glenracing/bmw-e36-abs-adapter/Readme.md

# bmw-e36-abs-adapter

BMW E36 ABS pedal travel sensor adapter and CANbus module.
