glenracing/bmw-e36-abs-adapter/stm32_pinout.png

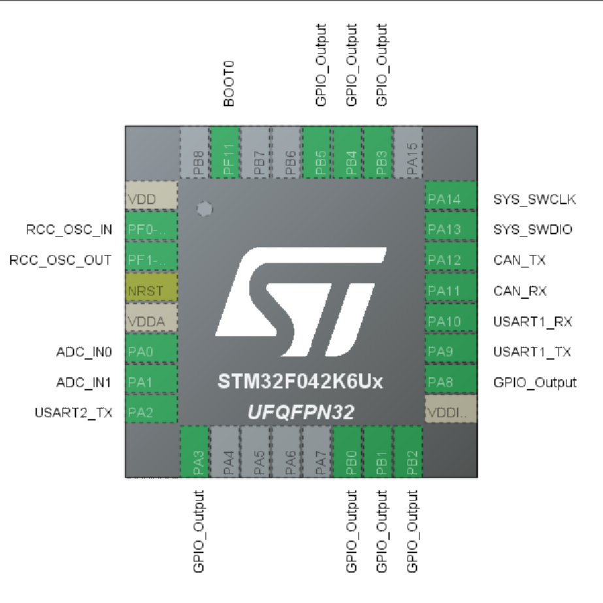
stm32_pinout.png
