glenracing/bmw-e36-abs-adapter/kicad/3d-models/SOP-4_4.4x4.6mm_P2.54mm.step

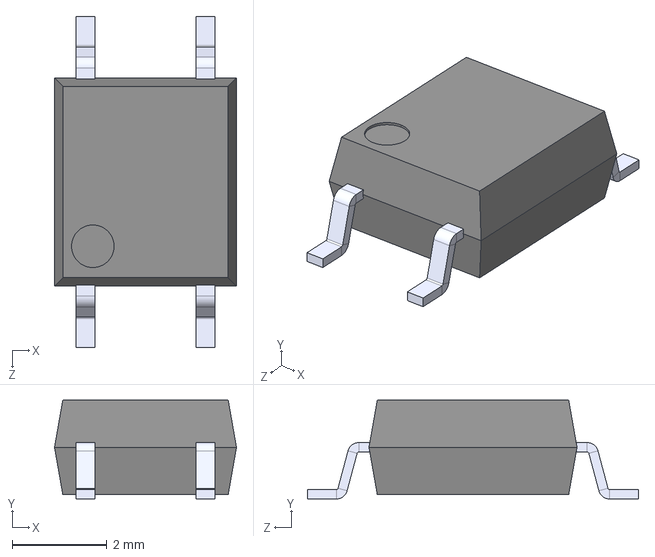
[picture p2: CAD file, 2026-04-06]
kicad/3d-models/SOP-4_4.4x4.6mm_P2.54mm.step
3.85 x 2.09 x 7.00 mm
