glenracing/bmw-e36-abs-adapter/kicad/3d-models/Texas_RDN0011B_QFN-FCMOD-11-3.5x4.5mm-P0.5mm_2EP.step

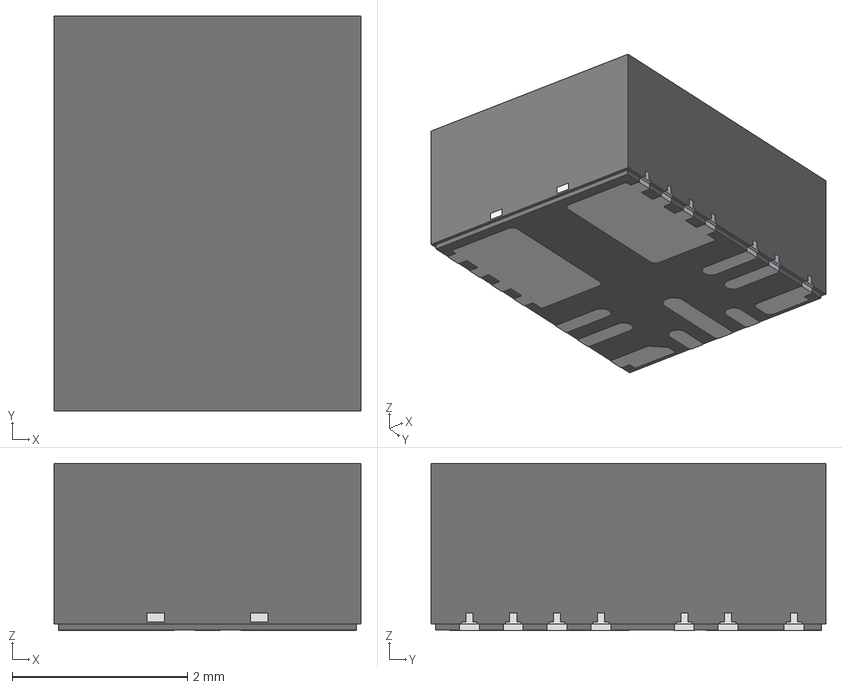
[picture p3: CAD file, 2026-04-06]
kicad/3d-models/Texas_RDN0011B_QFN-FCMOD-11-3.5x4.5mm-P0.5mm_2EP.step
3.50 x 4.50 x 1.91 mm
MOLD_CPOMPOUND_AF0
SOLID1-489_AF0
SOLID1-490_AF0
SOLID1-491_AF0
SOLID1-492_AF0
SOLID1-493_AF0
SOLID1-494_AF0
SOLID1-495_AF0
SOLID1-496_AF0
SOLID1-497_AF0
SOLID1-498_AF0
