glenracing/bmw-e36-abs-adapter/kicad/3d-models/TE_9-6437287-8.step

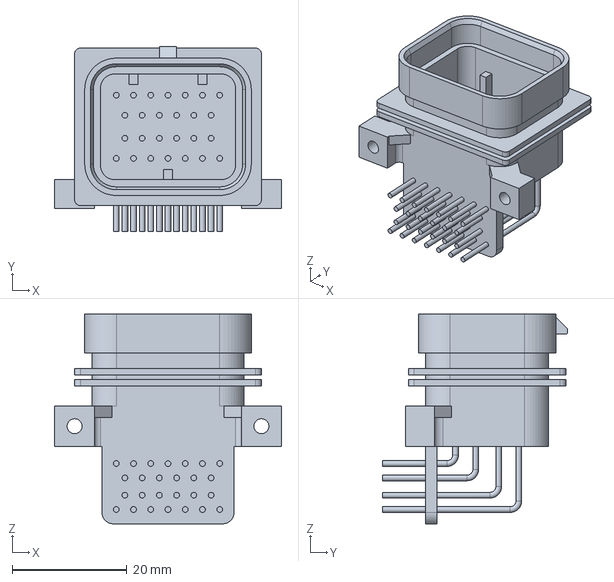
[picture p4: CAD file, 2026-04-06]
kicad/3d-models/TE_9-6437287-8.step
39.5 x 32.1 x 36.5 mm
