glenracing/bmw-e36-abs-adapter/release/Schematic.pdf

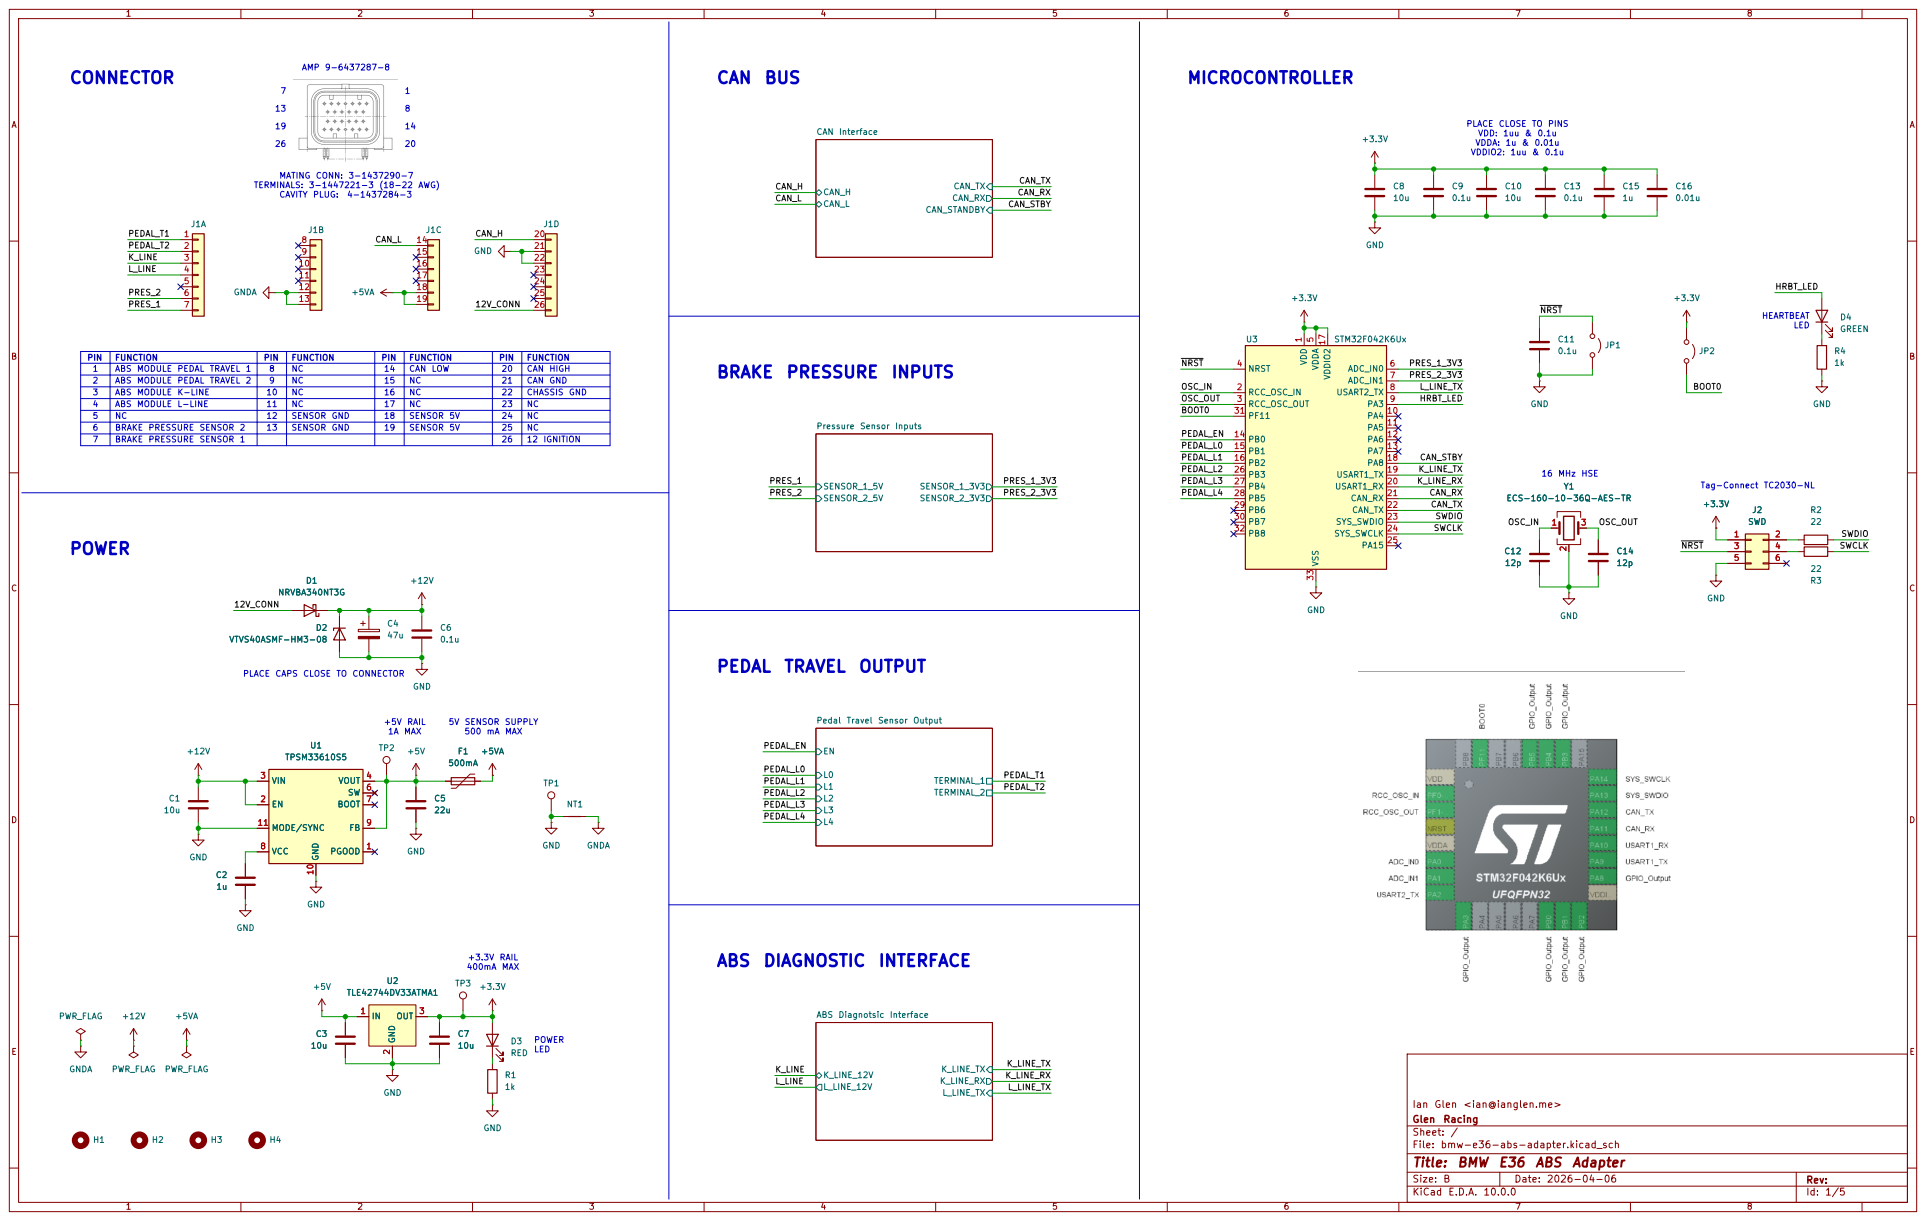
[picture p5: page 1]

CAVITY PLUG: 4-1437284-3 +5V RAIL 1A MAX CONNECTOR

16 MHz HSE CAN BUS

Tag-Connect TC2030-NL MATING CONN: 3-1437290-7

1 | ABS MODULE PEDAL TRAVEL 1 | 8 | NC | 14 | CAN LOW | 20 | CAN HIGH
2 | ABS MODULE PEDAL TRAVEL 2 | 9 | NC | 15 | NC | 21 | CAN GND
3 | ABS MODULE K-LINE | 10 | NC | 16 | NC | 22 | CHASSIS GND
4 | ABS MODULE L-LINE | 11 | NC | 17 | NC | 23 | NC
5 | NC | 12 | SENSOR GND | 18 | SENSOR 5V | 24 | NC
6 | BRAKE PRESSURE SENSOR 2 | 13 | SENSOR GND | 19 | SENSOR 5V | 25 | NC

5V SENSOR SUPPLY 500 mA MAX POWER

PLACE CAPS CLOSE TO CONNECTOR

TERMINAL_2 Pedal Travel Sensor Output GND

Ian Glen <ian@ianglen.me>
Glen Racing
Sheet: /
File: bmw-e36-abs-adapter.kicad_sch
Title: BMW E36 ABS Adapter

Size: B | Rev:

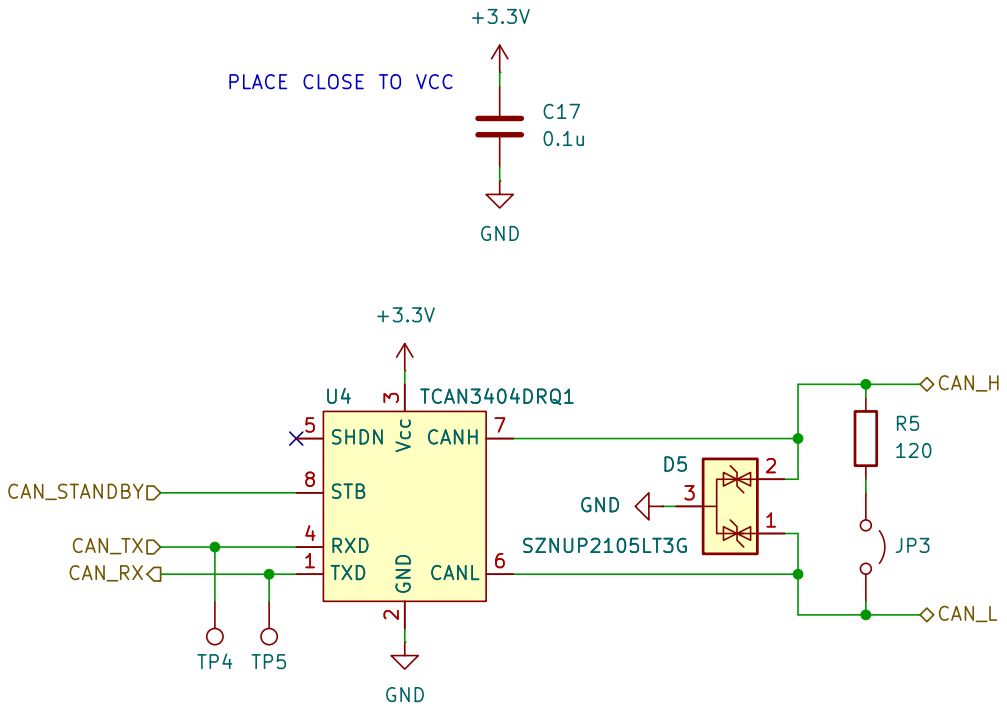
[picture p6: page 2]

2 Vcc 3 RXD 4 CANL 6 CANH 7

Ian Glen <ian@ianglen.me>
Glen Racing
Sheet: /CAN Interface/
File: canbus.kicad_sch
Title: CAN Interface

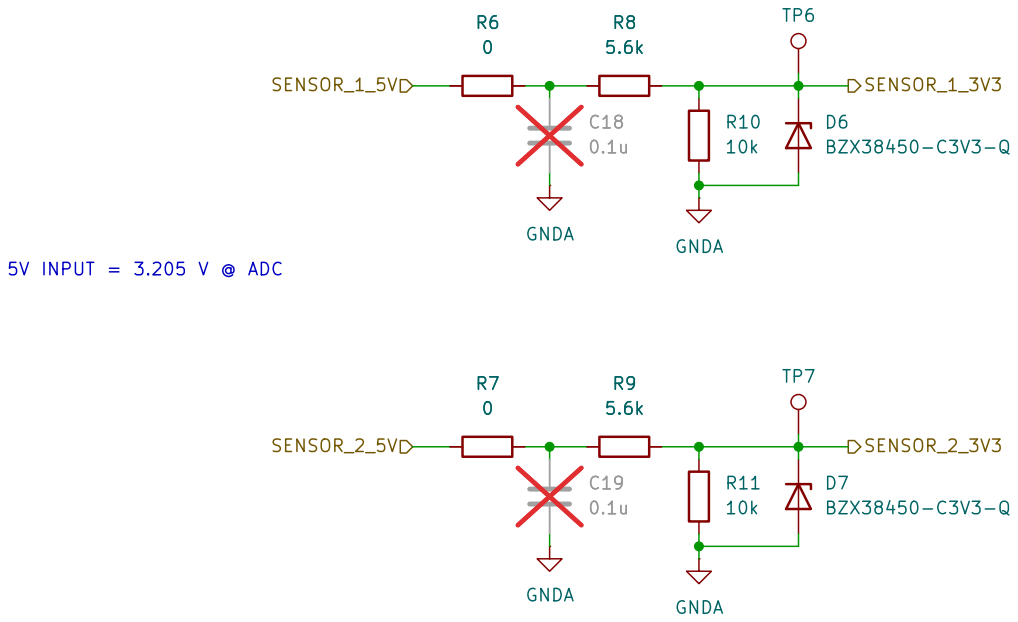
[picture p7: page 3]

Ian Glen <ian@ianglen.me>
Glen Racing
Sheet: /Pressure Sensor Inputs/
File: pressure-sensor-inputs.kicad_sch
Title: Brake Pressure Sensor Inputs

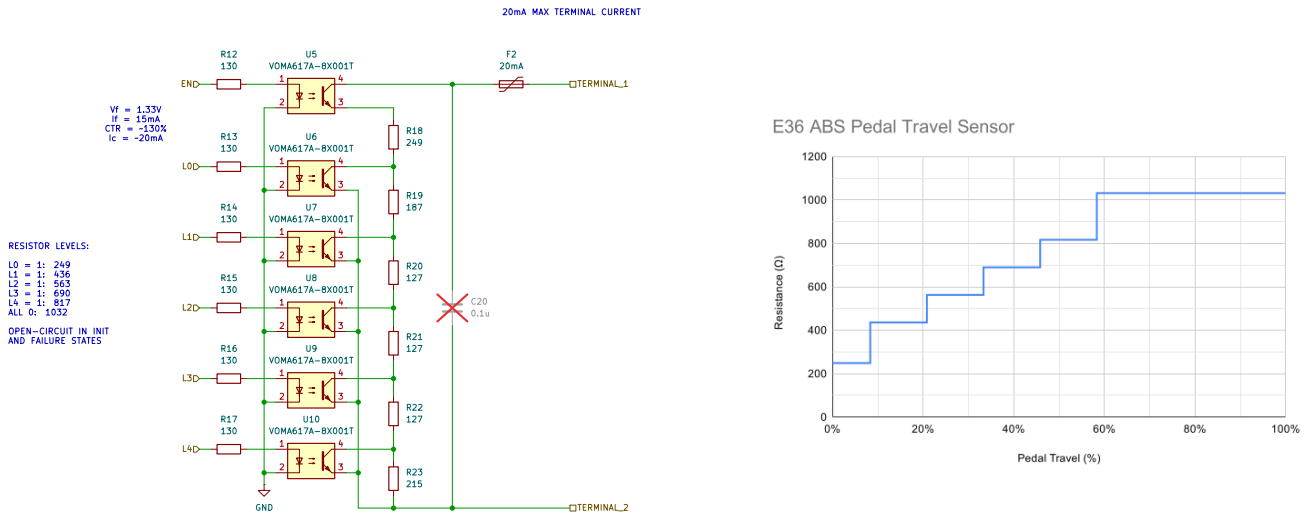
[picture p8: page 4]

Ian Glen <ian@ianglen.me>
Glen Racing
Sheet: /Pedal Travel Sensor Output/
File: pedal-travel-sensor-output.kicad_sch
Title: Pedal Travel Sensor Output

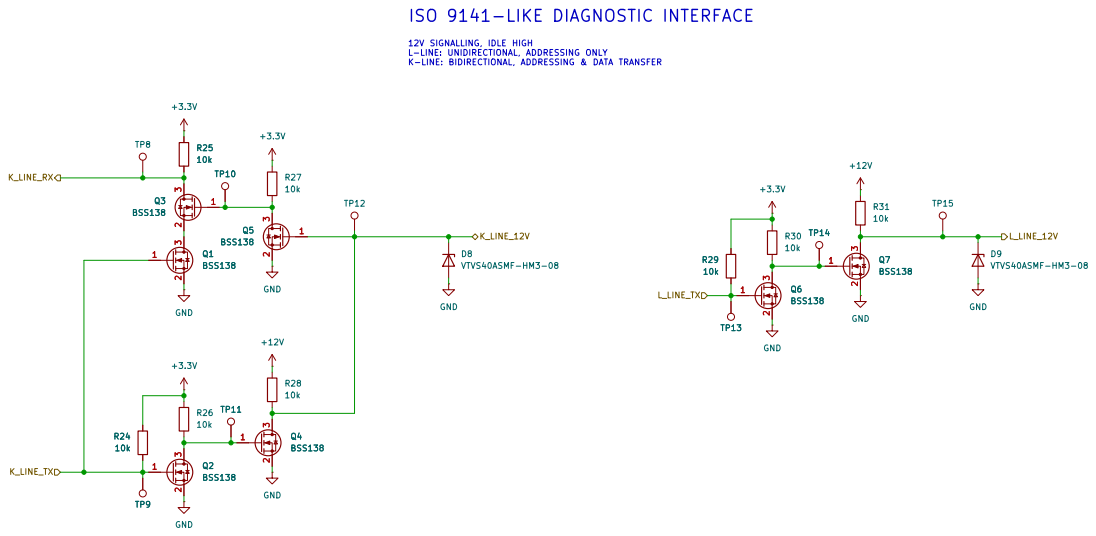
[picture p9: page 5]

ISO 9141-LIKE DIAGNOSTIC INTERFACE

L-LINE: UNIDIRECTIONAL, ADDRESSING ONLY K-LINE: BIDIRECTIONAL, ADDRESSING & DATA TRANSFER Q3 BSS138

Ian Glen <ian@ianglen.me>
Glen Racing
Sheet: /ABS Diagnotsic Interface/
File: abs-interface.kicad_sch
Title: ABS Diagnostic Interface
