glenracing/bmw-e36-abs-adapter/release/BOM.pdf

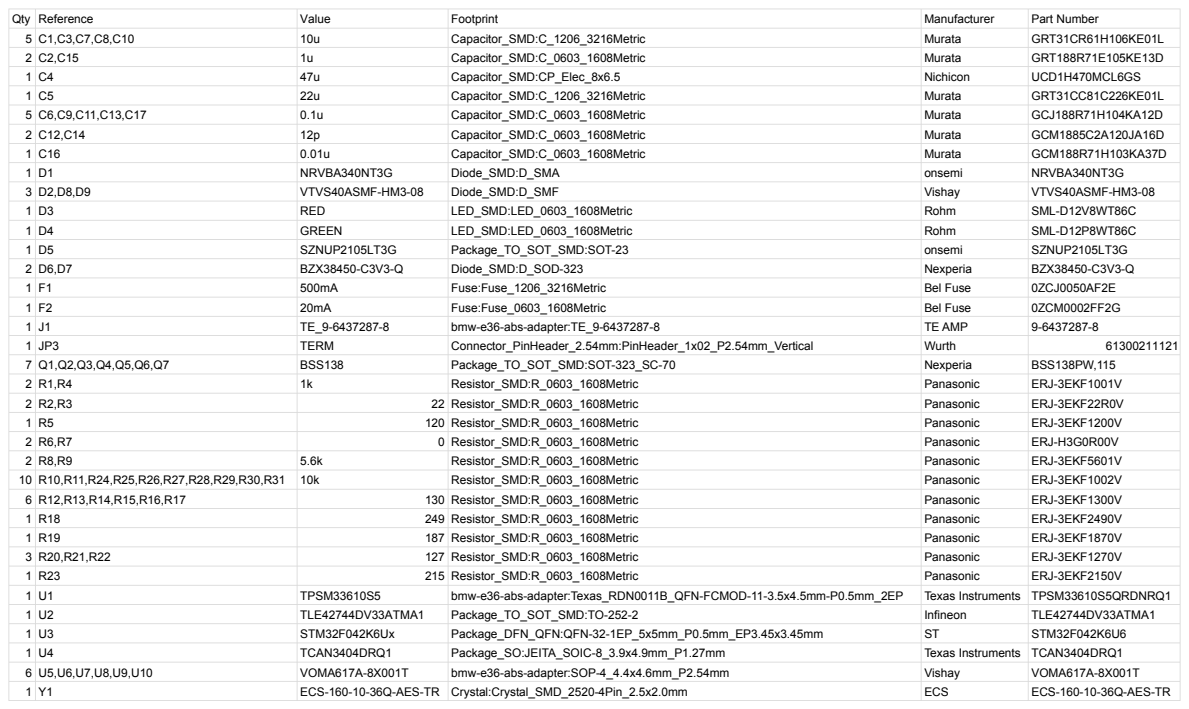
[picture p10: page 1]
