glenracing/bmw-e36-abs-adapter/kicad/bmw-e36-abs-adapter.kicad_pcb

## KiCad design kicad/bmw-e36-abs-adapter.kicad_pcb (2026-04-11)

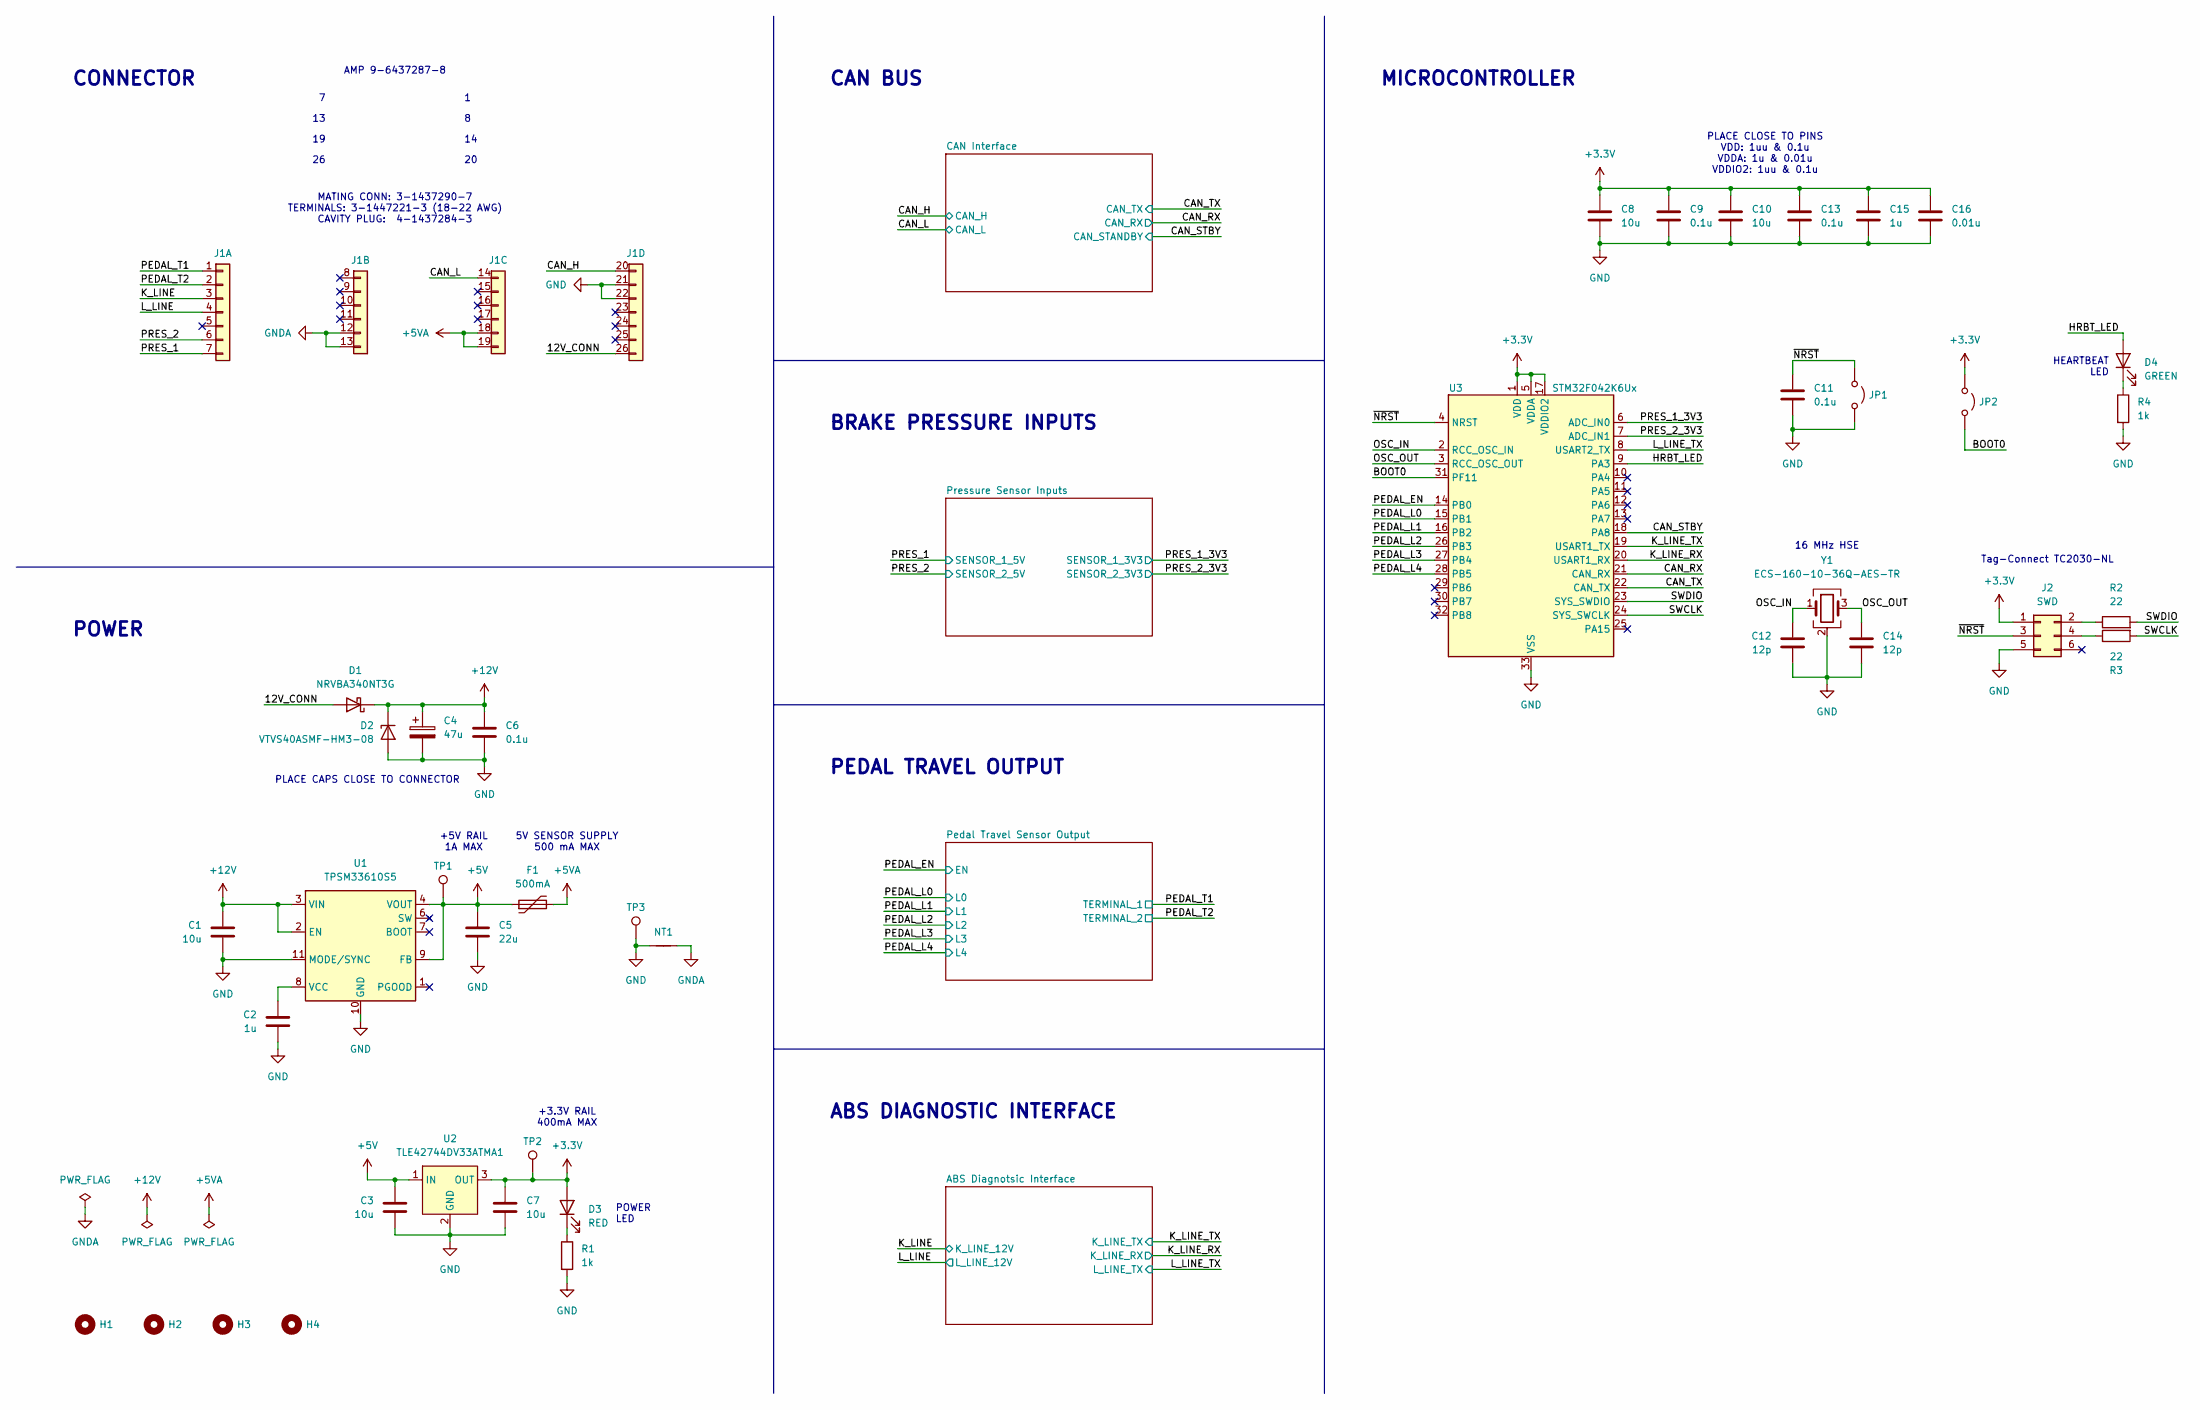
[picture p11: schematic bmw-e36-abs-adapter.kicad_sch, BMW E36 ABS Adapter]

Parts:
C1, C3, C7, C8, C10: 10u; C_1206_3216Metric; Part Number GRT31CR61H106KE01L
C2, C15: 1u; C_0603_1608Metric; Part Number GRT188R71E105KE13D
C4: 47u; CP_Elec_8x6.5; Part Number UCD1H470MCL6GS
C5: 22u; C_1206_3216Metric; Part Number GRT31CC81C226KE01L
C6, C9, C11, C13: 0.1u; C_0603_1608Metric; Part Number GCJ188R71H104KA12D
C12, C14: 12p; C_0603_1608Metric; Part Number GCM1885C2A120JA16D
C16: 0.01u; C_0603_1608Metric; Part Number GCM188R71H103KA37D
D1: NRVBA340NT3G; D_SMA; Part Number NRVBA340NT3G
D2: VTVS40ASMF-HM3-08; D_SMF; Part Number VTVS40ASMF-HM3-08
D3: RED; LED_0603_1608Metric; Part Number SML-D12V8WT86C
D4: GREEN; LED_0603_1608Metric; Part Number SML-D12P8WT86C
F1: 500mA; Fuse_1206_3216Metric; Part Number 0ZCJ0050AF2E
H1, H2, H3, H4: MountingHole; MountingHole_3.2mm_M3
J1: TE_9-6437287-8; Part Number 9-6437287-8
J2: SWD; Tag-Connect_TC2030-IDC-NL_2x03_P1.27mm_Vertical
JP1: RST; SolderJumper-2_P1.3mm_Open_RoundedPad1.0x1.5mm
JP2: BOOT; SolderJumper-2_P1.3mm_Open_RoundedPad1.0x1.5mm
NT1: NetTie_2; NetTie-2_SMD_Pad0.5mm
R1, R4: 1k; R_0603_1608Metric; Part Number ERJ-3EKF1001V
R2, R3: 22; R_0603_1608Metric; Part Number ERJ-3EKF22R0V
TP1, TP2: TestPoint; TestPoint_Pad_D1.5mm
TP3: TestPoint; TestPoint_Keystone_5000-5004_Miniature
U1: TPSM33610S5; Texas_RDN0011B_QFN-FCMOD-11-3.5x4.5mm-P0.5mm_2EP; Part Number TPSM33610S5QRDNRQ1
U2: TLE42744DV33ATMA1; TO-252-2; Part Number TLE42744DV33ATMA1
U3: STM32F042K6Ux; QFN-32-1EP_5x5mm_P0.5mm_EP3.45x3.45mm; Part Number STM32F042K6U6
Y1: ECS-160-10-36Q-AES-TR; Crystal_SMD_2520-4Pin_2.5x2.0mm; Part Number ECS-160-10-36Q-AES-TR

Connections:
+5VA: F1.2, J1.18, J1.19
+12V: C1.1, C4.1, C6.1, D1.1 (K), D2.1 (K), U1.2 (EN), U1.3 (VIN); also elsewhere on the board
/12V_CONN: D1.2 (A), J1.26
/BOOT0: JP2.2 (B), U3.31 (PF11)
/CAN_H: J1.20; also elsewhere on the board
/CAN_L: J1.14; also elsewhere on the board
/CAN_RX: U3.21 (CAN_RX); also elsewhere on the board
/CAN_STBY: U3.18 (PA8); also elsewhere on the board
/CAN_TX: U3.22 (CAN_TX); also elsewhere on the board
/HRBT_LED: D4.2 (A), U3.9 (PA3)
/K_LINE: J1.3; also elsewhere on the board
/K_LINE_RX: U3.20 (USART1_RX); also elsewhere on the board
/K_LINE_TX: U3.19 (USART1_TX); also elsewhere on the board
/L_LINE: J1.4; also elsewhere on the board
/L_LINE_TX: U3.8 (USART2_TX); also elsewhere on the board
/OSC_IN: C12.1, U3.2 (RCC_OSC_IN), Y1.1
/OSC_OUT: C14.1, U3.3 (RCC_OSC_OUT), Y1.3
/PEDAL_EN: U3.14 (PB0); also elsewhere on the board
/PEDAL_L0: U3.15 (PB1); also elsewhere on the board
/PEDAL_L1: U3.16 (PB2); also elsewhere on the board
/PEDAL_L2: U3.26 (PB3); also elsewhere on the board
/PEDAL_L3: U3.27 (PB4); also elsewhere on the board
/PEDAL_L4: U3.28 (PB5); also elsewhere on the board
/PEDAL_T1: J1.1; also elsewhere on the board
/PEDAL_T2: J1.2; also elsewhere on the board
/PRES_1: J1.7; also elsewhere on the board
/PRES_1_3V3: U3.6 (ADC_IN0); also elsewhere on the board
/PRES_2: J1.6; also elsewhere on the board
/PRES_2_3V3: U3.7 (ADC_IN1); also elsewhere on the board
/SWCLK: R3.2, U3.24 (SYS_SWCLK)
/SWDIO: R2.2, U3.23 (SYS_SWDIO)
/~NRST: C11.1, J2.3, JP1.1 (A), U3.4 (NRST)
GNDA: J1.12, J1.13, NT1.2; also elsewhere on the board
unnamed: D3.1 (K), R1.1
unnamed: D4.1 (K), R4.1
unnamed: J2.2, R2.1
unnamed: J2.4, R3.1
unnamed: C2.1, U1.8 (VCC)

Notes on the sheet:
16 MHz HSE
HEARTBEAT LED
PEDAL TRAVEL OUTPUT
AMP 9-6437287-8
Tag-Connect TC2030-NL
+5V RAIL 1A MAX
POWER LED
CONNECTOR
CAN BUS
PLACE CLOSE TO PINS VDD: 1uu & 0.1u VDDA: 1u & 0.01u VDDIO2: 1uu & 0.1u
MATING CONN: 3-1437290-7 TERMINALS: 3-1447221-3 (18-22 AWG) CAVITY PLUG: 4-1437284-3
MICROCONTROLLER
BRAKE PRESSURE INPUTS
+3.3V RAIL 400mA MAX
5V SENSOR SUPPLY 500 mA MAX
PLACE CAPS CLOSE TO CONNECTOR
ABS DIAGNOSTIC INTERFACE
POWER

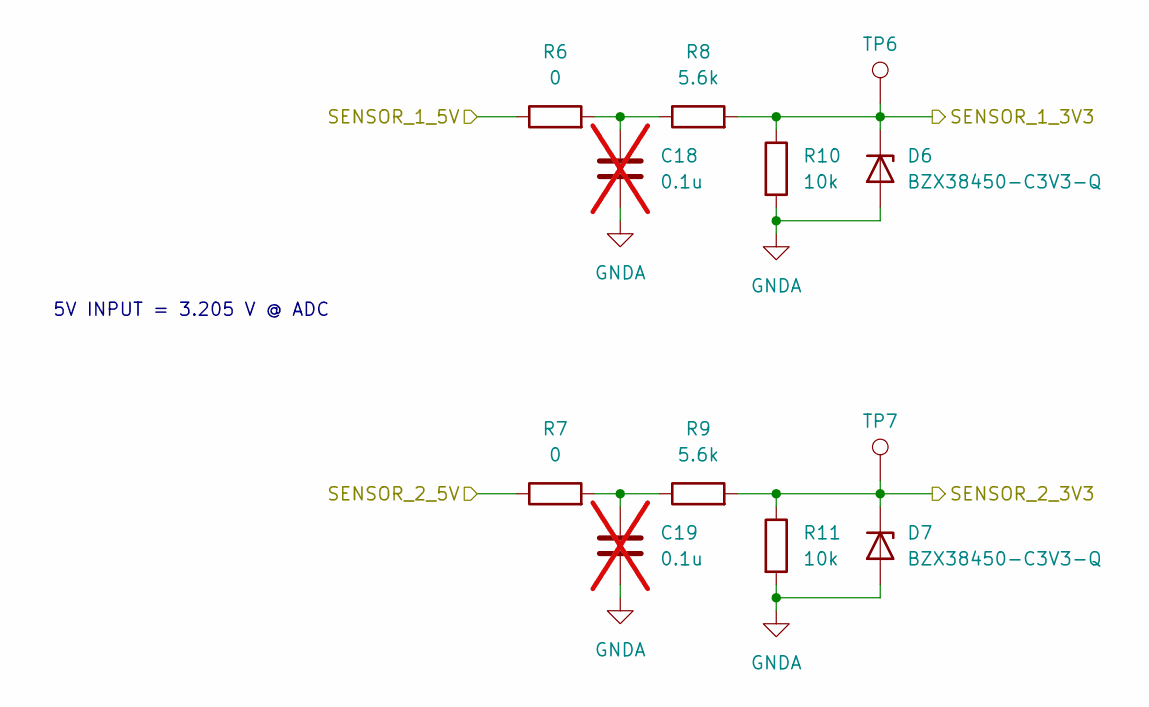
[picture p12: schematic pressure-sensor-inputs.kicad_sch, Brake Pressure Sensor Inputs]

Parts:
C18, C19: 0.1u; C_0603_1608Metric; Part Number GCJ188R71H104KA12D; not fitted
D6, D7: BZX38450-C3V3-Q; D_SOD-323; Part Number BZX38450-C3V3-Q
R6, R7: 0; R_0603_1608Metric; Part Number ERJ-H3G0R00V
R8, R9: 5.6k; R_0603_1608Metric; Part Number ERJ-3EKF5601V
R10, R11: 10k; R_0603_1608Metric; Part Number ERJ-3EKF1002V
TP6, TP7: TestPoint; TestPoint_Pad_D1.5mm

Connections:
/PRES_1: R6.1; also elsewhere on the board
/PRES_1_3V3: D6.1 (K), R8.2, R10.1, TP6.1 (1_1); also elsewhere on the board
/PRES_2: R7.1; also elsewhere on the board
/PRES_2_3V3: D7.1 (K), R9.2, R11.1, TP7.1 (1_1); also elsewhere on the board
GNDA: C18.2, C19.2, D6.2 (A), D7.2 (A), R10.2, R11.2; also elsewhere on the board
unnamed: C18.1, R6.2, R8.1
unnamed: C19.1, R7.2, R9.1

Notes on the sheet:
5V INPUT = 3.205 V @ ADC

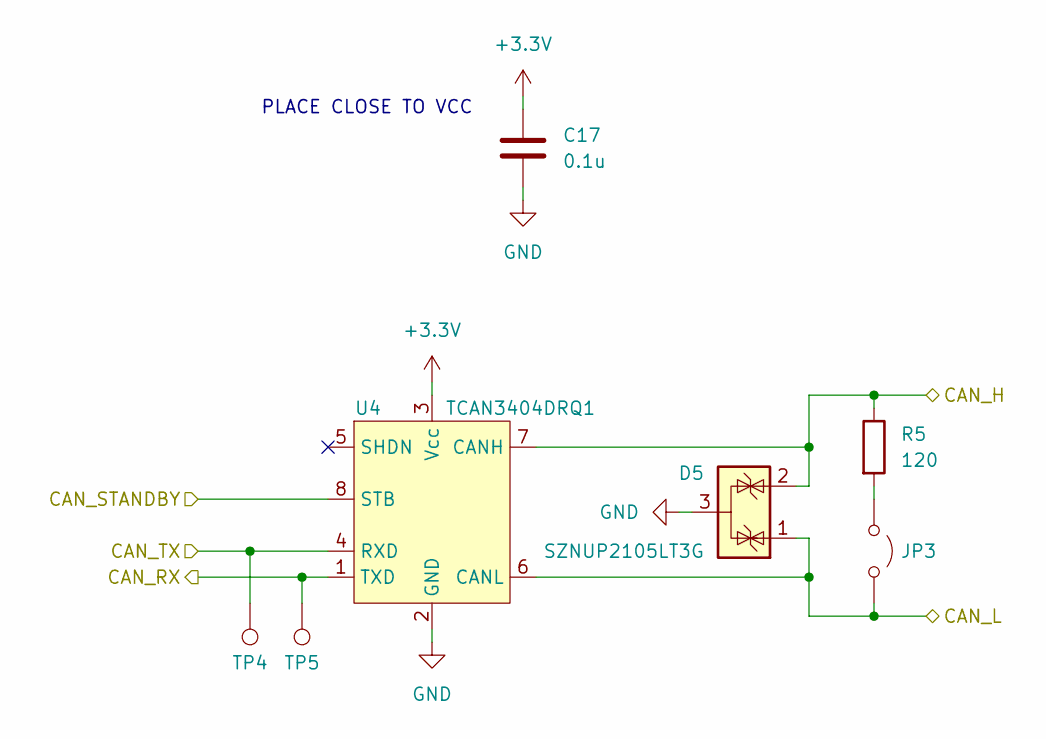
[picture p13: schematic canbus.kicad_sch, CAN Interface]

Parts:
C17: 0.1u; C_0603_1608Metric; Part Number GCJ188R71H104KA12D
D5: SZNUP2105LT3G; SOT-23; Part Number SZNUP2105LT3G
JP3: TERM; PinHeader_1x02_P2.54mm_Vertical; Part Number 61300211121
R5: 120; R_0603_1608Metric; Part Number ERJ-3EKF1200V
TP4, TP5: TestPoint; TestPoint_Pad_D1.5mm
U4: TCAN3404DRQ1; JEITA_SOIC-8_3.9x4.9mm_P1.27mm; Part Number TCAN3404DRQ1

Connections:
/CAN_H: D5.2 (K), R5.1, U4.7 (CANH); also elsewhere on the board
/CAN_L: D5.1 (K), JP3.2 (B), U4.6 (CANL); also elsewhere on the board
/CAN_RX: TP5.1 (1_1), U4.1 (TXD); also elsewhere on the board
/CAN_STBY: U4.8 (STB); also elsewhere on the board
/CAN_TX: TP4.1 (1_1), U4.4 (RXD); also elsewhere on the board
unnamed: JP3.1 (A), R5.2

Notes on the sheet:
PLACE CLOSE TO VCC

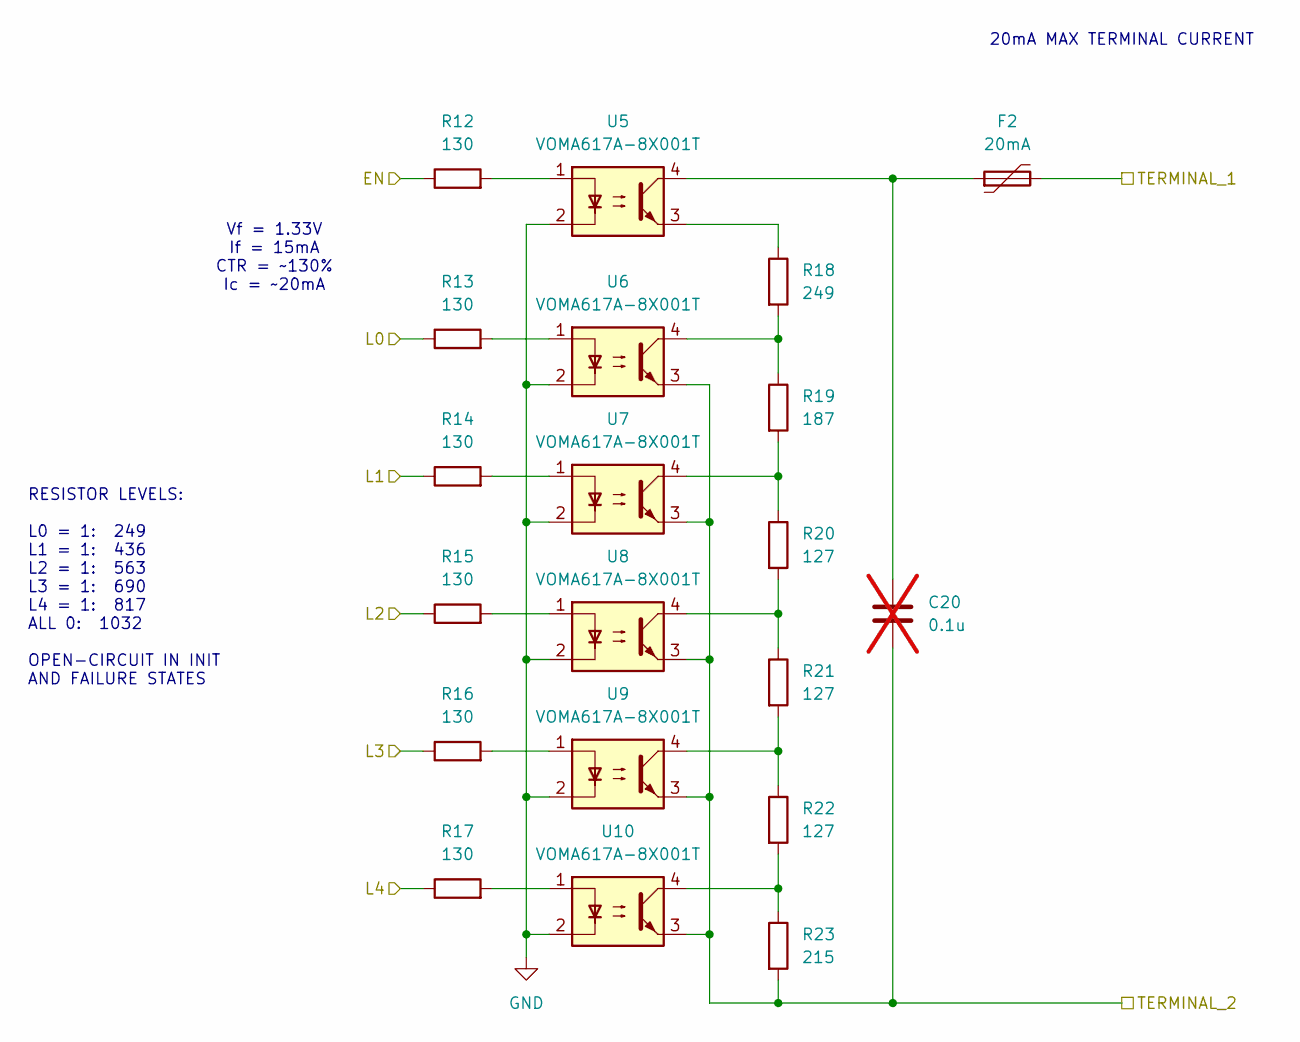
[picture p14: schematic pedal-travel-sensor-output.kicad_sch, Pedal Travel Sensor Output]

Parts:
C20: 0.1u; C_0603_1608Metric; Part Number GCJ188R71H104KA12D; not fitted
F2: 20mA; Fuse_0603_1608Metric; Part Number 0ZCM0002FF2G
R12, R13, R14, R15, R16, R17: 130; R_0603_1608Metric; Part Number ERJ-3EKF1300V
R18: 249; R_0603_1608Metric; Part Number ERJ-3EKF2490V
R19: 187; R_0603_1608Metric; Part Number ERJ-3EKF1870V
R20, R21, R22: 127; R_0603_1608Metric; Part Number ERJ-3EKF1270V
R23: 215; R_0603_1608Metric; Part Number ERJ-3EKF2150V
U5, U6, U7, U8, U9, U10: VOMA617A-8X001T; SOP-4_4.4x4.6mm_P2.54mm; Part Number VOMA617A-8X001T

Connections:
/PEDAL_EN: R12.1; also elsewhere on the board
/PEDAL_L0: R13.1; also elsewhere on the board
/PEDAL_L1: R14.1; also elsewhere on the board
/PEDAL_L2: R15.1; also elsewhere on the board
/PEDAL_L3: R16.1; also elsewhere on the board
/PEDAL_L4: R17.1; also elsewhere on the board
/PEDAL_T1: F2.2; also elsewhere on the board
/PEDAL_T2: C20.2, R23.2, U6.3, U7.3, U8.3, U9.3, U10.3; also elsewhere on the board
unnamed: C20.1, F2.1, U5.4
unnamed: R12.2, U5.1
unnamed: R13.2, U6.1
unnamed: R14.2, U7.1
unnamed: R15.2, U8.1
unnamed: R16.2, U9.1
unnamed: R17.2, U10.1
unnamed: R18.1, U5.3
unnamed: R18.2, R19.1, U6.4
unnamed: R19.2, R20.1, U7.4
unnamed: R20.2, R21.1, U8.4
unnamed: R21.2, R22.1, U9.4
unnamed: R22.2, R23.1, U10.4

Notes on the sheet:
20mA MAX TERMINAL CURRENT
Vf = 1.33V If = 15mA CTR = ~130% Ic = ~20mA
RESISTOR LEVELS: L0 = 1: 249 L1 = 1: 436 L2 = 1: 563 L3 = 1: 690 L4 = 1: 817 ALL 0: 1032 OPEN-CIRCUIT IN INIT AND FAILURE STATES

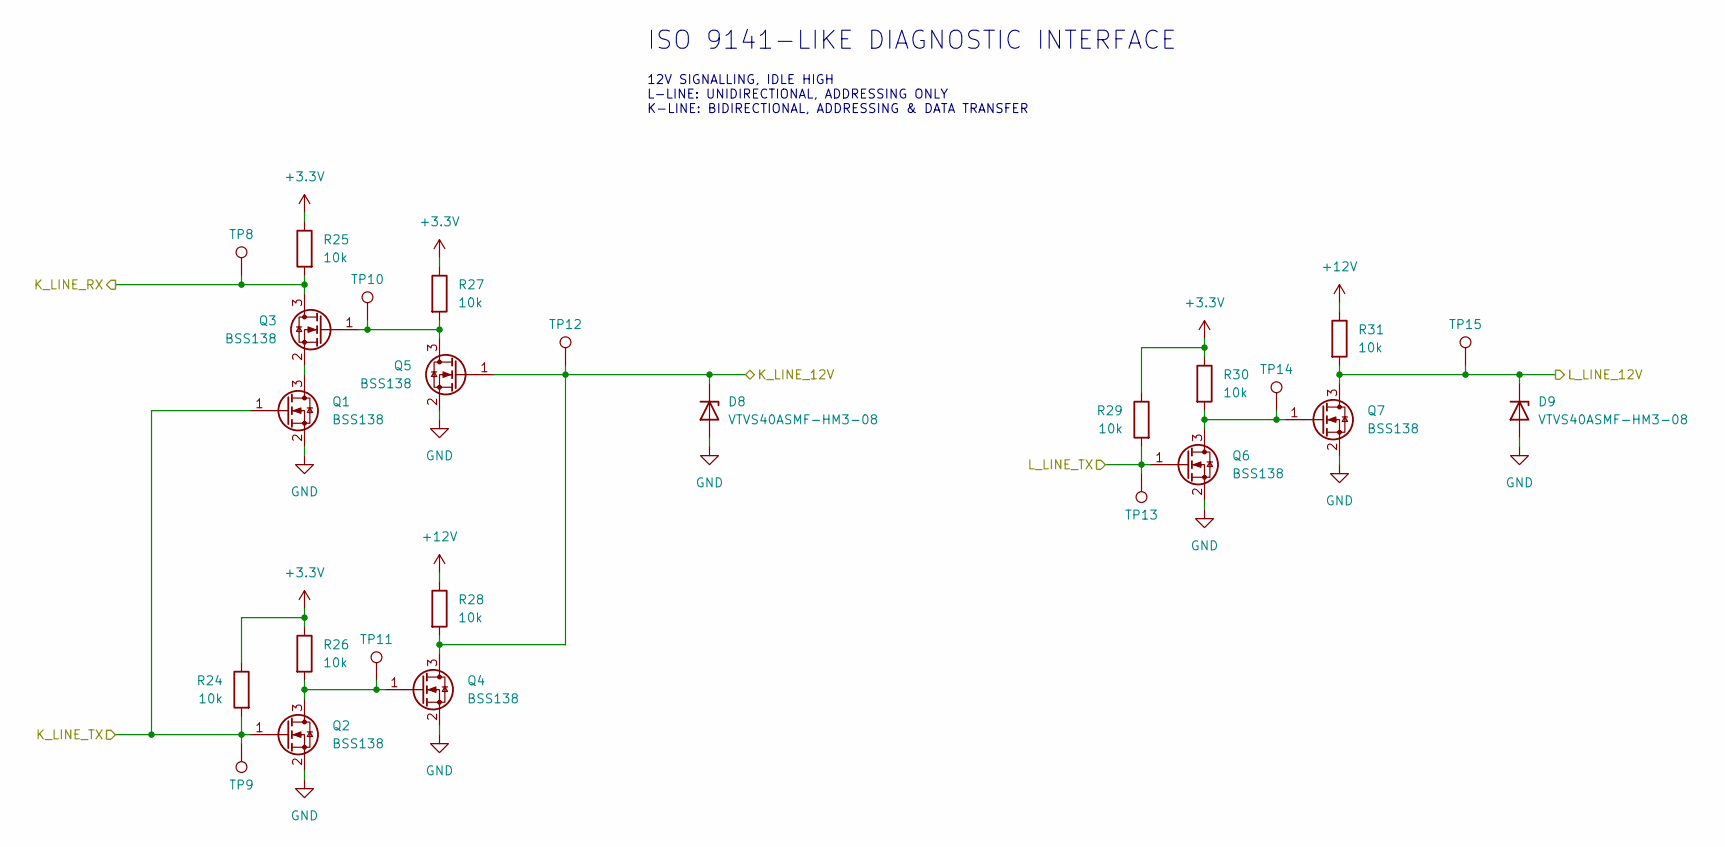
[picture p15: schematic abs-interface.kicad_sch, ABS Diagnostic Interface]

Parts:
D8, D9: VTVS40ASMF-HM3-08; D_SMF; Part Number VTVS40ASMF-HM3-08
Q1, Q2, Q3, Q4, Q5, Q6, Q7: BSS138; SOT-323_SC-70; Part Number BSS138PW,115
R24, R25, R26, R27, R28, R29, R30, R31: 10k; R_0603_1608Metric; Part Number ERJ-3EKF1002V
TP8, TP9, TP10, TP11, TP12, TP13, TP14, TP15: TestPoint; TestPoint_Pad_D1.5mm

Connections:
+12V: R28.1, R31.1; also elsewhere on the board
/K_LINE: D8.1 (K), Q4.3 (D), Q5.1 (G), R28.2, TP12.1 (1_1); also elsewhere on the board
/K_LINE_RX: Q3.3 (D), R25.2, TP8.1 (1_1); also elsewhere on the board
/K_LINE_TX: Q1.1 (G), Q2.1 (G), R24.2, TP9.1 (1_1); also elsewhere on the board
/L_LINE: D9.1 (K), Q7.3 (D), R31.2, TP15.1 (1_1); also elsewhere on the board
/L_LINE_TX: Q6.1 (G), R29.2, TP13.1 (1_1); also elsewhere on the board
unnamed: Q1.3 (D), Q3.2 (S)
unnamed: Q2.3 (D), Q4.1 (G), R26.2, TP11.1 (1_1)
unnamed: Q3.1 (G), Q5.3 (D), R27.2, TP10.1 (1_1)
unnamed: Q6.3 (D), Q7.1 (G), R30.2, TP14.1 (1_1)

Notes on the sheet:
ISO 9141-LIKE DIAGNOSTIC INTERFACE
12V SIGNALLING, IDLE HIGH L-LINE: UNIDIRECTIONAL, ADDRESSING ONLY K-LINE: BIDIRECTIONAL, ADDRESSING & DATA TRANSFER

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
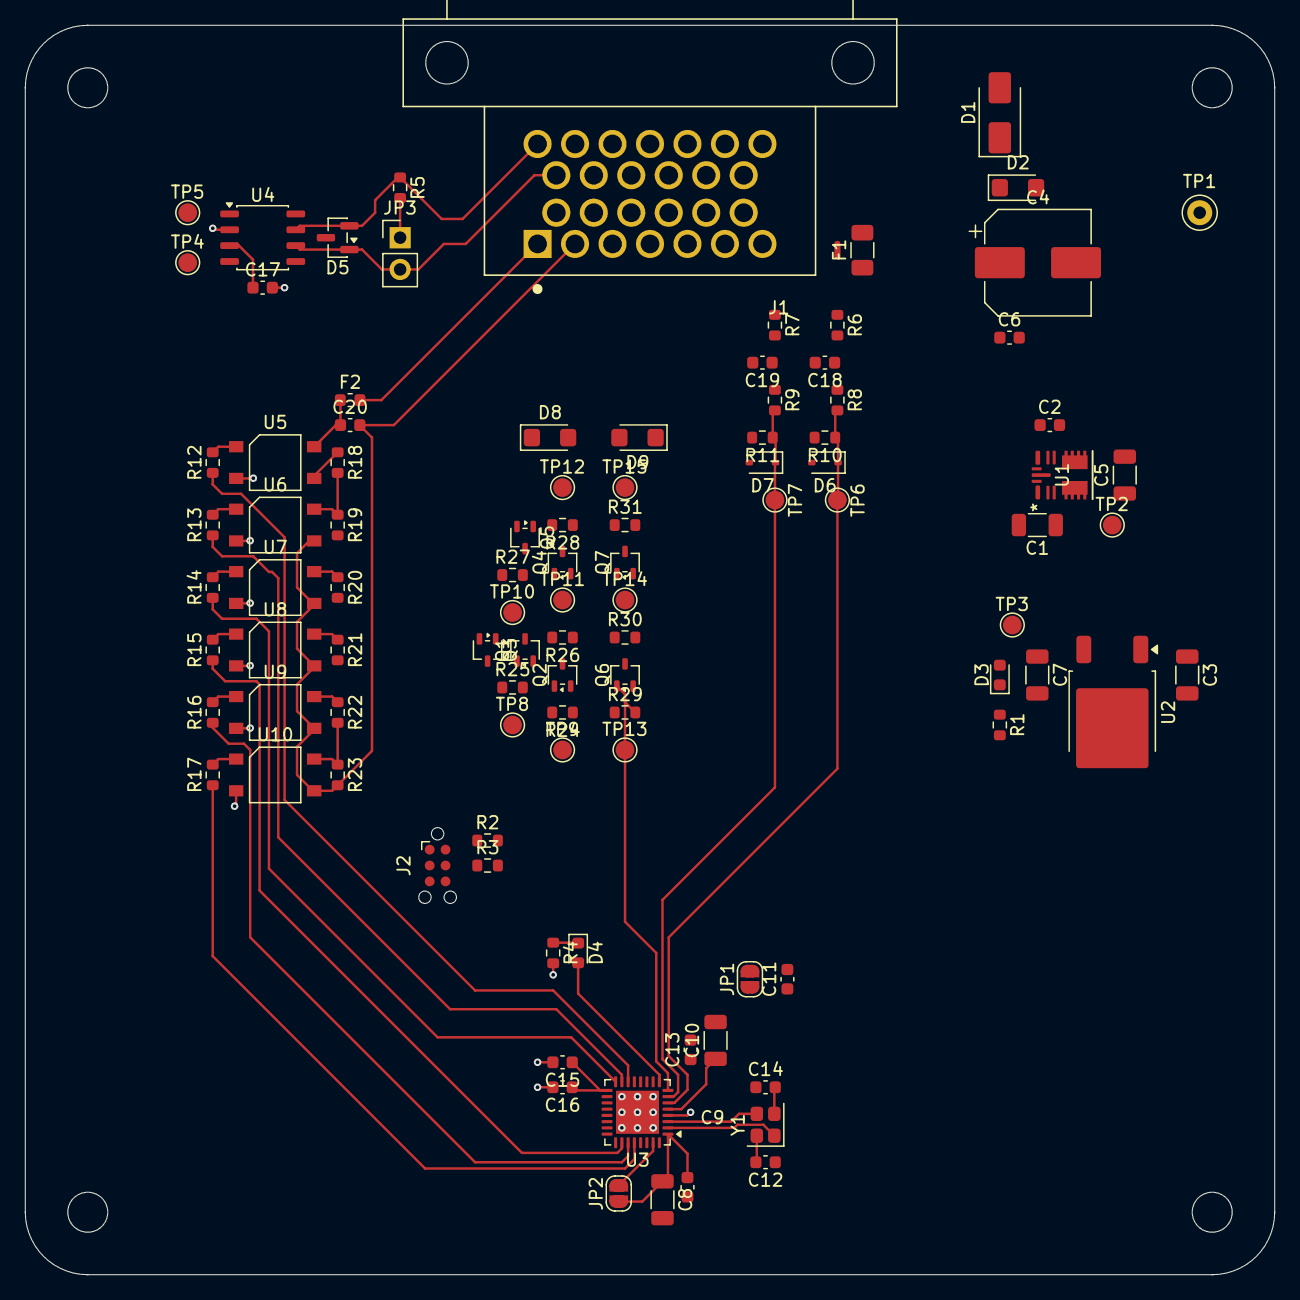
[picture p16: board bmw-e36-abs-adapter.kicad_pcb from above]

Board: 2 copper layers, 100.0 x 100.0 mm, 105 parts (0 on the bottom side), 61 nets.
