glenracing/bmw-e36-abs-adapter/(commit log)

2026-04-06 Update power architecture and input protection
    [bmw-e36-abs-adapter.kicad_sch]
2026-04-06 Update canbus TVS protection
    [canbus.kicad_sch]
2026-04-06 Update ADC input divider and protection
    [pressure-sensor-inputs.kicad_sch]
2026-04-06 Update pedal travel output
    [pedal-travel-sensor-output.kicad_sch]
2026-04-06 Update ABS diagnostic interface
    [abs-interface.kicad_sch, bmw-e36-abs-adapter.kicad_sch]
2026-04-06 Update connector; annotate and assign footprints
    [TE_9-6437287-8.step, abs-interface.kicad_sch, bmw-e36-abs-adapter.kicad_sch, canbus.kicad_sch, pedal-travel-sensor-output.kicad_sch, pressure-sensor-inputs.kicad_sch]
2026-04-06 Add optional RC filter to pressure sensor inputs
    [abs-interface.kicad_sch, bmw-e36-abs-adapter.kicad_sch, pedal-travel-sensor-output.kicad_sch, pressure-sensor-inputs.kicad_sch]
2026-04-06 Add jumper for canbus termination
    [canbus.kicad_sch]
2026-04-06 Update footprints
    [SOP-4_4.4x4.6mm_P2.54mm.step, Texas_RDN0011B_QFN-FCMOD-11-3.5x4.5mm-P0.5mm_2EP.step, bmw-e36-abs-adapter.kicad_sch, canbus.kicad_sch, pedal-travel-sensor-output.kicad_sch]
2026-04-06 Update part numbers and fix ERC issues
    [abs-interface.kicad_sch, bmw-e36-abs-adapter.kicad_sch, canbus.kicad_sch, pedal-travel-sensor-output.kicad_sch, pressure-sensor-inputs.kicad_sch]
2026-04-06 Export schematic and BOM
    [BOM.csv]
2026-04-07 BOM consolidation
    [abs-interface.kicad_sch]
2026-04-07 Use 3.3V LDO from ADC CAN module
    [abs-interface.kicad_sch, bmw-e36-abs-adapter.kicad_sch, canbus.kicad_sch, pedal-travel-sensor-output.kicad_sch, pressure-sensor-inputs.kicad_sch]
2026-04-07 Update schematic and BOM
    [BOM.csv]
2026-04-07 Initial placement on PCB
    [abs-interface.kicad_sch, bmw-e36-abs-adapter.kicad_pcb, bmw-e36-abs-adapter.kicad_sch, canbus.kicad_sch, pressure-sensor-inputs.kicad_sch]
2026-04-11 PCB Design WIP
    [abs-interface.kicad_sch, bmw-e36-abs-adapter.kicad_pcb, bmw-e36-abs-adapter.kicad_sch, canbus.kicad_sch, pedal-travel-sensor-output.kicad_sch, pressure-sensor-inputs.kicad_sch]
